z1ntus/VRC-CB-Digital-Heating-Controller/images/pcb_installed.jpg

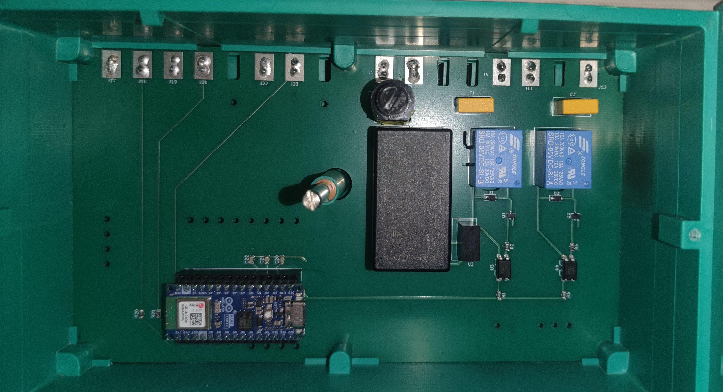
images/pcb_installed.jpg
