z1ntus/VRC-CB-Digital-Heating-Controller/images/pcb_front.jpg

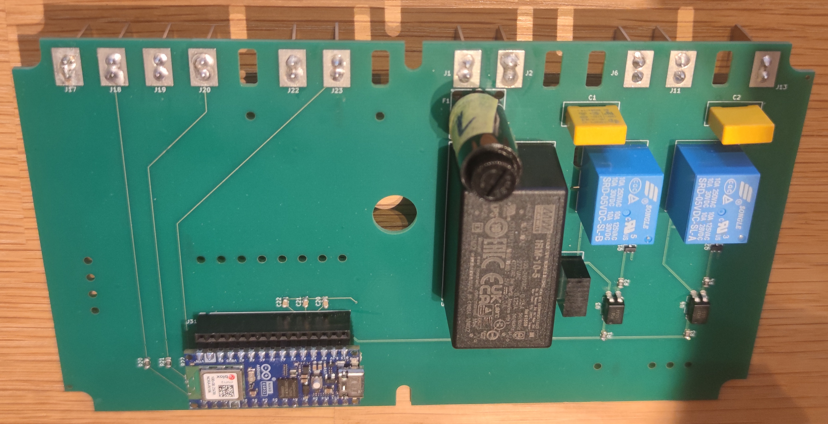
images/pcb_front.jpg
