z1ntus/VRC-CB-Digital-Heating-Controller/firmware/README.md

# Firmware

Place the final Arduino Nano ESP32 firmware source here.
