z1ntus/VRC-CB-Digital-Heating-Controller/images/README.md

# Images

Place project photographs, PCB images and diagrams here.
