z1ntus/VRC-CB-Digital-Heating-Controller/hardware/gerbers/README.md

# Gerbers

Place the production Gerber and drill files here.
