z1ntus/VRC-CB-Digital-Heating-Controller/hardware/kicad/README.md

# KiCad source

Place the final KiCad project, schematic and PCB files here.
