z1ntus/VRC-CB-Digital-Heating-Controller/LICENSES/HARDWARE-LICENSE.md

# Hardware licence

The KiCad schematic, PCB layout and other original hardware design files in
this repository are intended to be licensed under:

**CERN Open Hardware Licence Version 2, Strongly Reciprocal
(CERN-OHL-S-2.0)**

SPDX identifier:

    CERN-OHL-S-2.0

The authoritative licence text is maintained by CERN:

https://cern-ohl.web.cern.ch/

CERN describes CERN-OHL-S as the strongly reciprocal variant of version 2.

Before publishing the repository, add the complete licence text supplied by
CERN as `LICENSE-CERN-OHL-S-2.0.txt`.
