z1ntus/VRC-CB-Digital-Heating-Controller/images/pcb_back.jpg

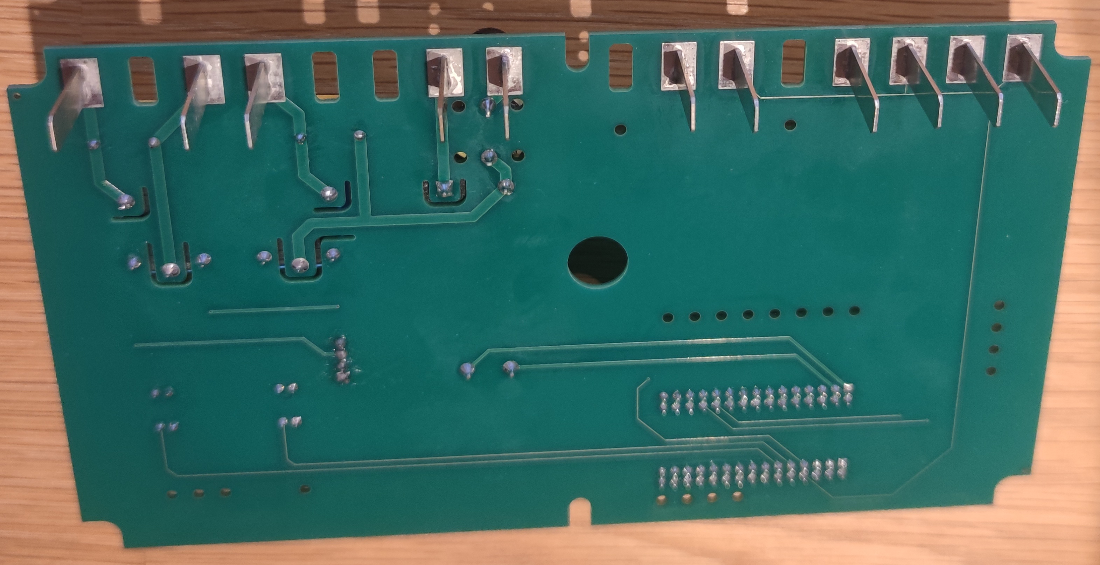
images/pcb_back.jpg
