z1ntus/VRC-CB-Digital-Heating-Controller/hardware/fabrication/BOM-external-parts.md

# Global System Bill of Materials (External Components)

These components are required to build the complete project, but they are **not** populated or soldered onto the PCB itself (e.g., external sensors, enclosures, or wiring).

| Part Name | Description | Type / Specification | Sourcing Example |
| :--- | :--- | :--- | :--- |
| **Arduino Nano ESP32 (with headers)** | Main microcontroller module | ESP32-S3, pre-soldered pins | Official Arduino Store / Distributor |
| **Vaillant VRC 693** | Outdoor wall temperature sensor | NTC sensor in housing | ebay for example |
| **Vaillant VRC 692** | Flow temperature sensor | NTC sensor in housing | ebay for example |
| **Vishay 1.5 kOhm** | NTC Thermistor | 1.5 kΩ, 3528 K, ±0.5% | ebay for example |
