z1ntus/VRC-CB-Digital-Heating-Controller/hardware/fabrication/WiFi_Boiler_Controller_pcb.xlsx

Reference | Qty | Value | DNP | Exclude from BOM | Exclude from Board | Footprint | Datasheet
C1,C2 | 2 | YX3001J |  |  |  | Capacitor_THT:C_Rect_L13.0mm_W6.0mm_P10.00mm_FKS3_FKP3_MKS4
C20,C22 | 2 | 100nF |  |  |  | Capacitor_SMD:C_0805_2012Metric
C21 | 1 | 100nf |  |  |  | Capacitor_SMD:C_0805_2012Metric
D1,D2 | 2 | SS14 |  |  |  | Diode_SMD:D_SOD-123
F1 | 1 | FX0456 |  |  |  | Fuse:Fuseholder_Cylinder-5x20mm_Bulgin_FX0456_Vertical_Closed
J1 | 1 | L |  |  |  | MyFootprints:Faston_Tab_Pad
J2 | 1 | N |  |  |  | MyFootprints:Faston_Tab_Pad
J6 | 1 | Pump |  |  |  | MyFootprints:Faston_Tab_Pad
J11 | 1 | Burner1 |  |  |  | MyFootprints:Faston_Tab_Pad
J13 | 1 | Burner2 |  |  |  | MyFootprints:Faston_Tab_Pad
J17 | 1 | GND_FLOW |  |  |  | MyFootprints:Faston_Tab_Pad
J18 | 1 | NTC_FLOW |  |  |  | MyFootprints:Faston_Tab_Pad
J19 | 1 | GND_OUT |  |  |  | MyFootprints:Faston_Tab_Pad
J20 | 1 | NTC_OUT |  |  |  | MyFootprints:Faston_Tab_Pad
J22 | 1 | GND_ROOM |  |  |  | MyFootprints:Faston_Tab_Pad
J23 | 1 | NTC_ROOM |  |  |  | MyFootprints:Faston_Tab_Pad
J30 | 1 | 2541FV-2x15P-B |  |  |  | Connector_PinSocket_2.54mm:PinSocket_2x15_P2.54mm_Vertical
J31 | 1 | 2541FV-2x15P-B |  |  |  | Connector_PinSocket_2.54mm:PinSocket_2x15_P2.54mm_Vertical
K1 | 1 | SRD-5VDC-SL-B |  |  |  | Relay_THT:Relay_SPST_SANYOU_SRD_Series_Form_B | http://www.sanyourelay.ca/public/products/pdf/SRD.pdf
K3 | 1 | SRD-5VDC-SL-A |  |  |  | Relay_THT:Relay_SPST_SANYOU_SRD_Series_Form_A | http://www.sanyourelay.ca/public/products/pdf/SRD.pdf
Q1,Q2 | 2 | SS8050 |  |  |  | Package_TO_SOT_SMD:SOT-23 | http://www.secosgmbh.com/datasheet/products/SSMPTransistor/SOT-23/SS8050.pdf
R1,R3 | 2 | 330 |  |  |  | Resistor_SMD:R_0805_2012Metric
R2,R4 | 2 | 1k |  |  |  | Resistor_SMD:R_0805_2012Metric
R20 | 1 | 2.2k |  |  |  | Resistor_SMD:R_0805_2012Metric
R21 | 1 | 1.5k |  |  |  | Resistor_SMD:R_0805_2012Metric
R22 | 1 | 1.8k |  |  |  | Resistor_SMD:R_0805_2012Metric
U1 | 1 | IRM-10-5 |  |  |  | Converter_ACDC:Converter_ACDC_MeanWell_IRM-10-xx_THT | https://www.meanwell.com/Upload/PDF/IRM-10/IRM-10-SPEC.PDF
U2 | 1 | MEE3S0505SC |  |  |  | Converter_DCDC:Converter_DCDC_Murata_MEE3SxxxxSC_THT | https://power.murata.com/pub/data/power/ncl/kdc_mee3.pdf
U3,U4 | 2 | PC817 |  |  |  | Package_DIP:DIP-4_W7.62mm | http://www.soselectronic.cz/a_info/resource/d/pc817.pdf
