z1ntus/VRC-CB-Digital-Heating-Controller/hardware/kicad/WiFi_Boiler_Controller_pcb/Steckzunge_Vogt-Body.step

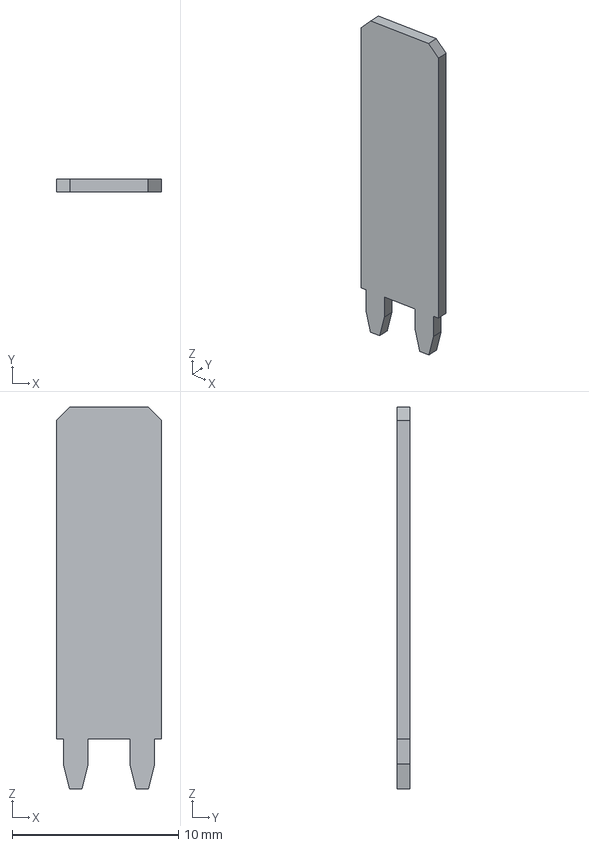
[picture p4: CAD file, 2026-09-22]
hardware/kicad/WiFi_Boiler_Controller_pcb/Steckzunge_Vogt-Body.step
6.30 x 0.8 x 23.0 mm
