z1ntus/VRC-CB-Digital-Heating-Controller/hardware/kicad/WiFi_Boiler_Controller_pcb/WiFi_Boiler_Controller_pcb.kicad_pcb

## KiCad design hardware/kicad/WiFi_Boiler_Controller_pcb/WiFi_Boiler_Controller_pcb.kicad_pcb (2026-09-22)

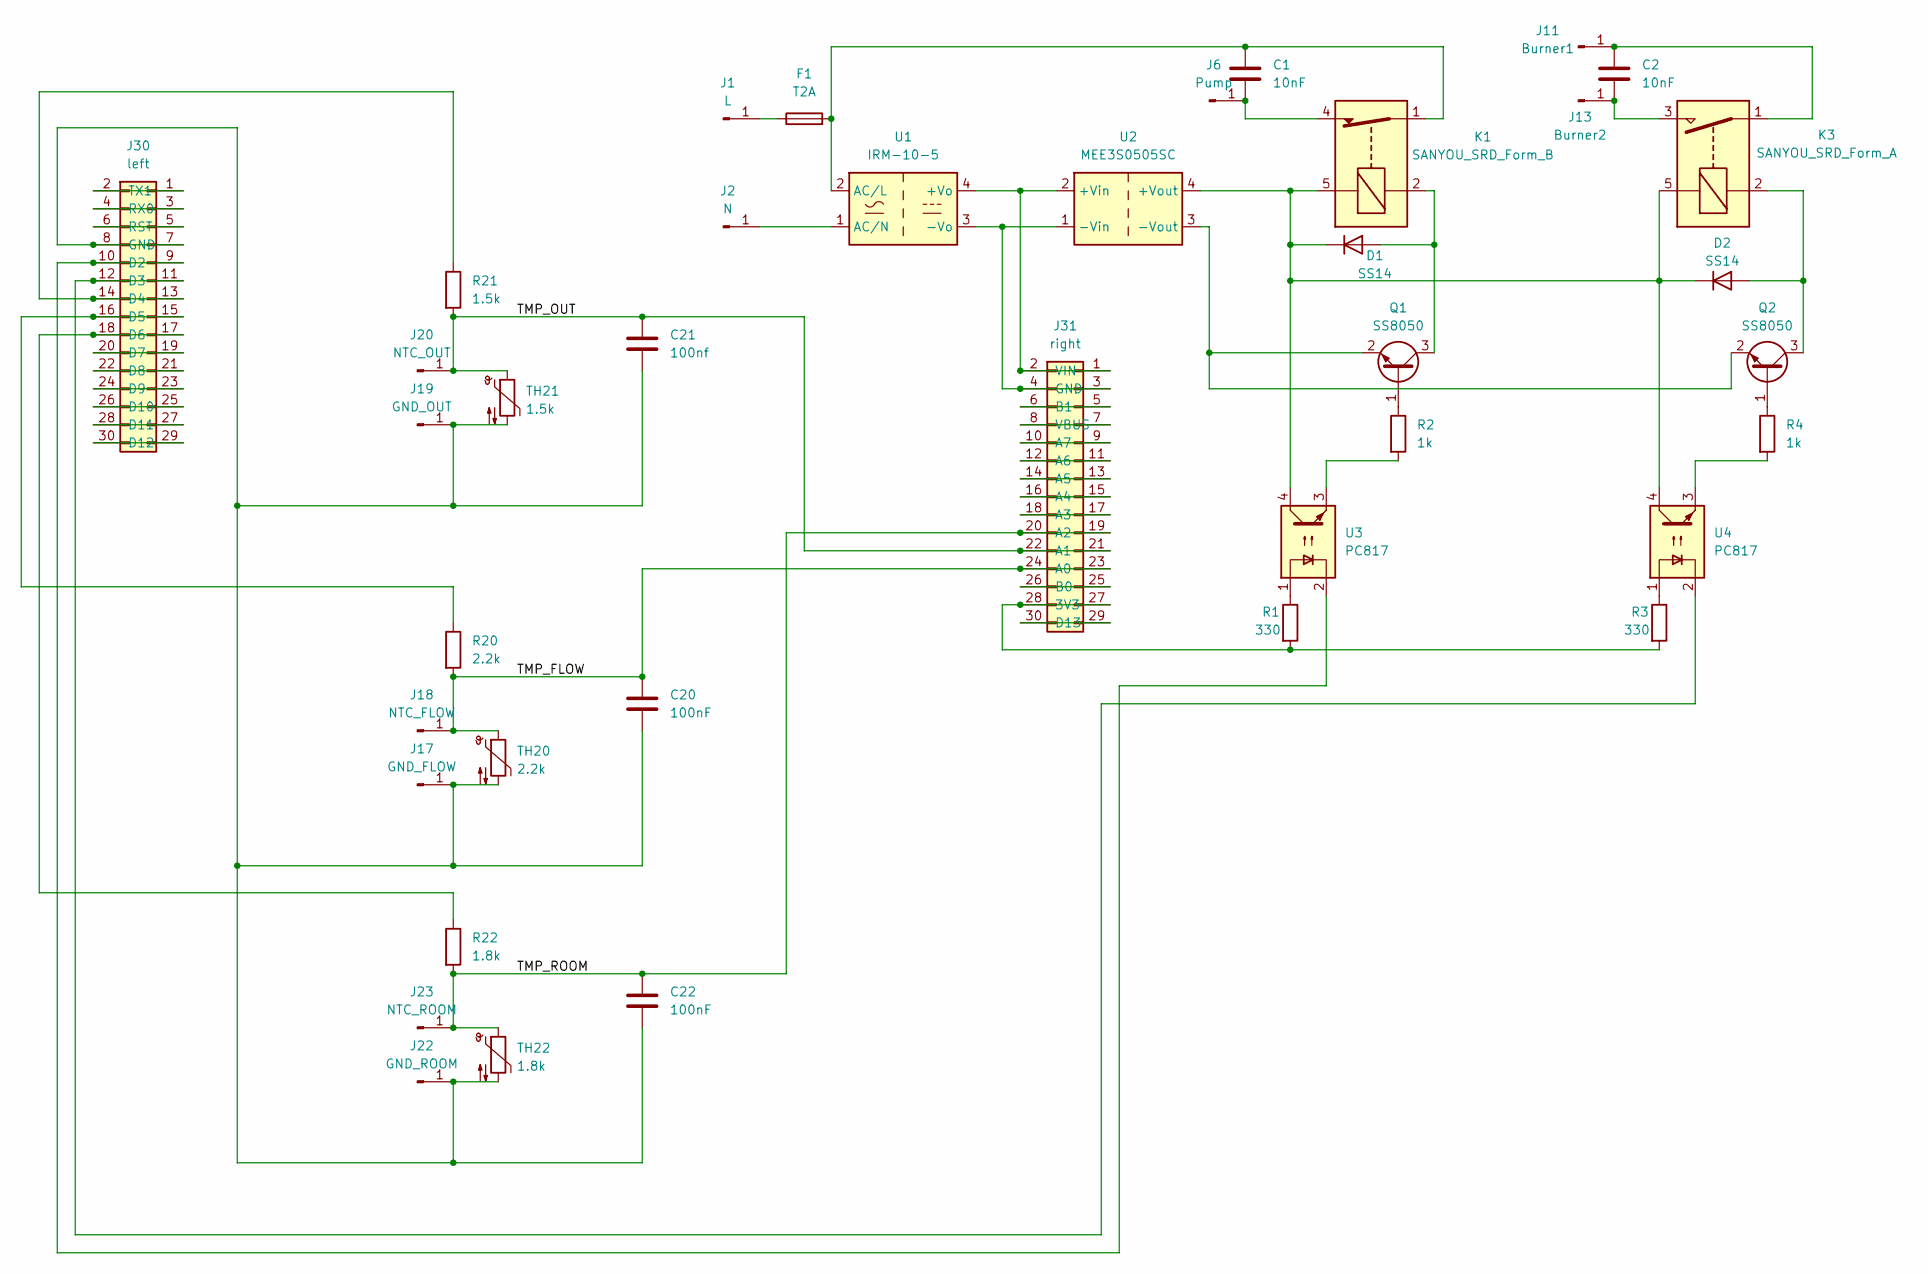
[picture p5: schematic WiFi_Boiler_Controller_pcb.kicad_sch]

Parts:
C1, C2: 10nF; C_Rect_L13.0mm_W6.0mm_P10.00mm_FKS3_FKP3_MKS4
C20, C22: 100nF; C_0805_2012Metric
C21: 100nf; C_0805_2012Metric
D1, D2: SS14; D_SOD-123
F1: T2A; Fuseholder_Cylinder-5x20mm_Bulgin_FX0456_Vertical_Closed
J1: L; Faston_Tab_Pad
J2: N; Faston_Tab_Pad
J6: Pump; Faston_Tab_Pad
J11: Burner1; Faston_Tab_Pad
J13: Burner2; Faston_Tab_Pad
J17: GND_FLOW; Faston_Tab_Pad
J18: NTC_FLOW; Faston_Tab_Pad
J19: GND_OUT; Faston_Tab_Pad
J20: NTC_OUT; Faston_Tab_Pad
J22: GND_ROOM; Faston_Tab_Pad
J23: NTC_ROOM; Faston_Tab_Pad
J30: left; PinSocket_2x15_P2.54mm_Vertical
J31: right; PinSocket_2x15_P2.54mm_Vertical
K1: SANYOU_SRD_Form_B; Relay_SPST_SANYOU_SRD_Series_Form_B
K3: SANYOU_SRD_Form_A; Relay_SPST_SANYOU_SRD_Series_Form_A
Q1, Q2: SS8050; SOT-23
R1, R3: 330; R_0805_2012Metric
R2, R4: 1k; R_0805_2012Metric
R20: 2.2k; R_0805_2012Metric
R21: 1.5k; R_0805_2012Metric
R22: 1.8k; R_0805_2012Metric
TH20: 2.2k
TH21: 1.5k
TH22: 1.8k
U1: IRM-10-5; Converter_ACDC_MeanWell_IRM-10-xx_THT
U2: MEE3S0505SC; Converter_DCDC_Murata_MEE3SxxxxSC_THT
U3, U4: PC817; DIP-4_W7.62mm

Connections:
/TMP_FLOW: C20.1, J18.1 (Pin_1_1), J31.23, J31.24 (A0), R20.2, TH20.1
/TMP_OUT: C21.1, J20.1 (Pin_1_1), J31.21, J31.22 (A1), R21.2, TH21.1
/TMP_ROOM: C22.1, J23.1 (Pin_1_1), J31.19, J31.20 (A2), R22.2, TH22.1
unnamed: D1.2 (A), K1.2, Q1.3 (C)
unnamed: D1.1 (K), D2.1 (K), K1.5, K3.5, U2.4 (+Vout), U3.4, U4.4
unnamed: D2.2 (A), K3.2, Q2.3 (C)
unnamed: F1.1, J1.1 (Pin_1_1)
unnamed: J2.1 (Pin_1_1), U1.1 (AC/N)
unnamed: C1.2, J6.1 (Pin_1_1), K1.4
unnamed: C2.1, J11.1 (Pin_1_1), K3.1
unnamed: C2.2, J13.1 (Pin_1_1), K3.3
unnamed: C20.2, C21.2, C22.2, J17.1 (Pin_1_1), J19.1 (Pin_1_1), J22.1 (Pin_1_1), J30.7, J30.8 (GND), TH20.2, TH21.2, TH22.2
unnamed: J30.9, J30.10 (D2), U3.2
unnamed: J30.11, J30.12 (D3), U4.2
unnamed: J30.13, J30.14 (D4), R21.1
unnamed: J30.15, J30.16 (D5), R20.1
unnamed: J30.17, J30.18 (D6), R22.1
unnamed: J30.19, J30.20 (D7)
unnamed: J30.21, J30.22 (D8)
unnamed: J30.23, J30.24 (D9)
unnamed: J30.25, J30.26 (D10)
unnamed: J30.27, J30.28 (D11)
unnamed: J30.29, J30.30 (D12)
unnamed: J30.5, J30.6 (RST)
unnamed: J30.3, J30.4 (RX0)
unnamed: J30.1, J30.2 (TX1)
unnamed: J31.27, J31.28 (3V3), R1.2, R3.2
unnamed: J31.17, J31.18 (A3)
unnamed: J31.15, J31.16 (A4)
unnamed: J31.13, J31.14 (A5)
unnamed: J31.11, J31.12 (A6)
unnamed: J31.9, J31.10 (A7)
unnamed: J31.25, J31.26 (B0)
unnamed: J31.5, J31.6 (B1)
unnamed: J31.29, J31.30 (D13)
unnamed: J31.3, J31.4 (GND), U1.3 (-Vo), U2.1 (-Vin)
unnamed: J31.7, J31.8 (VBUS)
unnamed: J31.1, J31.2 (VIN), U1.4 (+Vo), U2.2 (+Vin)
unnamed: Q1.1 (B), R2.1
unnamed: Q1.2 (E), Q2.2 (E), U2.3 (-Vout)
unnamed: Q2.1 (B), R4.1
unnamed: R1.1, U3.1
unnamed: R2.2, U3.3
unnamed: R3.1, U4.1
unnamed: R4.2, U4.3
unnamed: C1.1, F1.2, K1.1, U1.2 (AC/L)

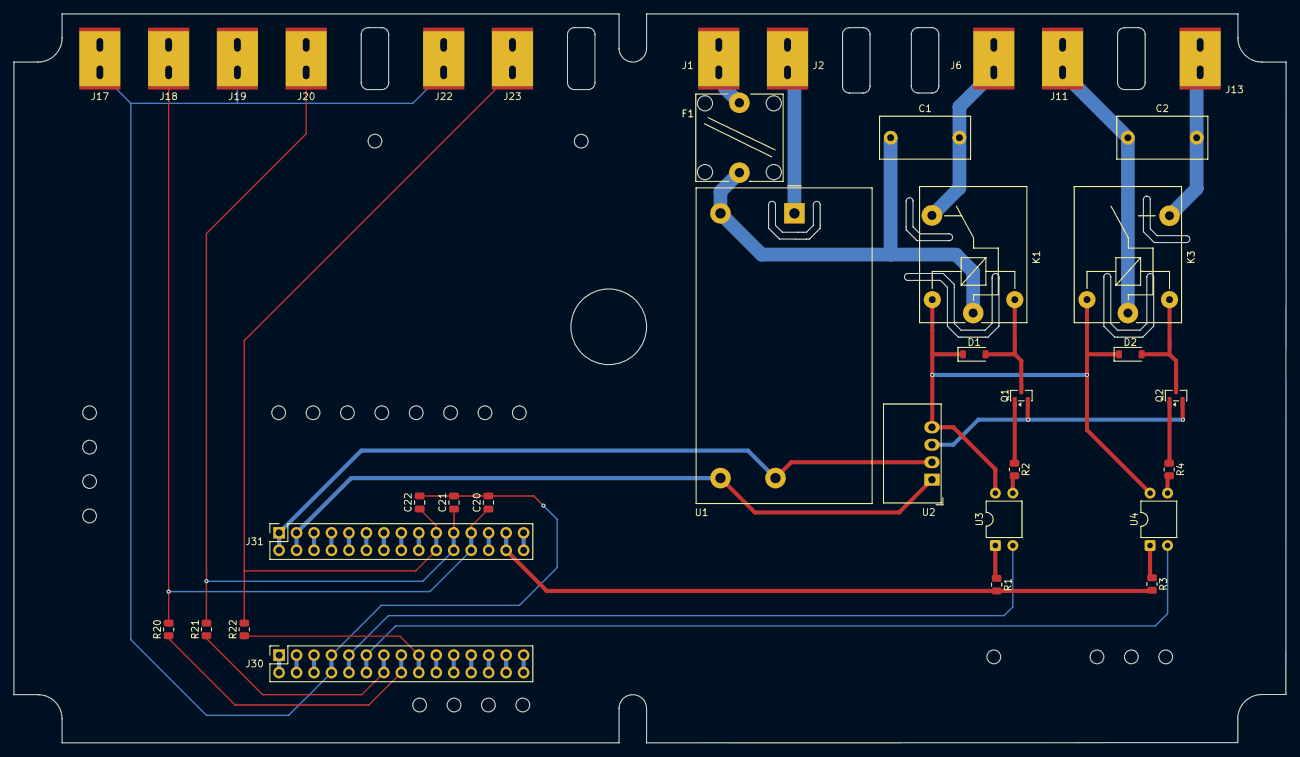
[picture p6: board WiFi_Boiler_Controller_pcb.kicad_pcb from above]

Board: 2 copper layers, 185.0 x 106.0 mm, 36 parts (0 on the bottom side), 46 nets.
