z1ntus/VRC-CB-Digital-Heating-Controller/(commit log)

2026-09-22 Initial project files
    [Steckzunge_Vogt-Body.step, WiFi_Boiler_Controller_pcb.kicad_pcb, WiFi_Boiler_Controller_pcb.kicad_sch, WiFi_Boiler_Controller_pcb.xlsx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]
2026-10-13 Fix variable name from vtCurve to vtCorrected in HTML output
    [VRC_CB_Digital_Heating_Controller.ino]
